MelonPie/ESP_Home_watering/(commit log)

2026-05-02 Publish initial state for leak/no-flow alerts; log zone advance
    - Publish false for leak_detected and no_flow_alert at end of irrigation_init()
    so HA shows a defined state on boot instead of "unknown".
    - Add INFO log when advancing to a zone (showing liters/duration values seen)
    and DEBUG log for skipped zones, to diagnose unexpected zone activations.
    [irrigation.h]
2026-05-02 Pin reassignment to GPIO12/13/14 and hardware doc refresh
    - Shift register pins moved from GPIO19/18/17 to GPIO14/13/12 across
    schematic, generator script, and docs
    - Document FS300A flow sensor with passive 1.8k/3.3k divider in place
    of the HW-221 active level shifter (TXS0108E latched against the
    open-collector signal)
    - Document the +12V valve / +5V logic / +3V3 (onboard reg) power rails
    - Add esphome/zone.yaml package include used by the per-zone refactor
    - Note old_version/ as ignored in CLAUDE.md
    [esp_watering.kicad_sch]
2026-05-02 Sync irrigation-micr-2.yaml with production device
    Pulled from the production controller: device renamed to
    irrigation-reloaded, API encryption key and OTA password rotated,
    AP SSID updated to match.
2026-05-03 Pin device to static IP 192.168.2.27
2026-05-03 Remap SR pins off boot-unsafe GPIOs, add /OE control
    Move data/clock/latch from GPIO14/13/12 (strapping + bootloader debug
    pulses, which clocked garbage into the SRs and energized valves at boot)
    to GPIO23/18/5. Add oe_pin GPIO16 in open-drain mode so an external 10k
    pull-up to +5V keeps all SR outputs disabled until ESPHome has shifted
    in zeros and drives /OE low.
2026-05-03 PCB: remap SR pins, route /OE through GPIO16 + 10k pull-up
    generate_schematic.py: SHIFT_REG_DATA/CLOCK/LATCH now GPIO23/18/5, new
    SHIFT_REG_OE = GPIO16. Replaces the GND-tied /OE on each SN74HC595 with
    a SR_OE net driven by ESP32 GPIO16 (open-drain) and pulled up to +5V by
    a new 10k resistor R3. /OE stays high through ESP32 reset / boot, so
    the SRs cannot energize valves on garbage contents.
    [esp_watering.kicad_sch]
2026-05-03 Doc pin remap and /OE pull-up in CLAUDE.md and README.md
    Reflect the move from GPIO14/13/12 to GPIO23/18/5 (+ GPIO16 /OE) and
    the 10k pull-up to +5V. Adds a paragraph in CLAUDE.md explaining why
    the original pins caused valves to energize at boot.
2026-05-03 Move SR latch from GPIO5 to GPIO17
    GPIO5 is listed in the ESP32 GPIO reference as a "PWM output at boot"
    pin (along with 1, 3, 14, 15) — the bootloader briefly toggles it.
    /OE held high already neutralizes that, but GPIO17 is unambiguously
    safe at boot (no strapping, no boot pulses), so use it instead.
    [esp_watering.kicad_sch]
2026-05-03 Calibrate flow sensor: 1700 pulses = 5 L
    Replace the placeholder multiply filter with calibrate_linear so the
    measured calibration (5 L bucket -> 1700 pulses) is expressed as the
    point pair instead of a multiplied-out 0.00294... factor. Applied to
    both flow_rate (pulses/min -> L/min) and flow_total (pulses -> L).
2026-05-30 Add TODO: swap FS300A for low-flow sensor (e.g. YF-B6)
    FS300A stalls below ~1 L/min, so an observed slow leak produced zero
    pulses and the leak detector could not see it.
